HeyImK/Vector-06/Images/vectrbl.png

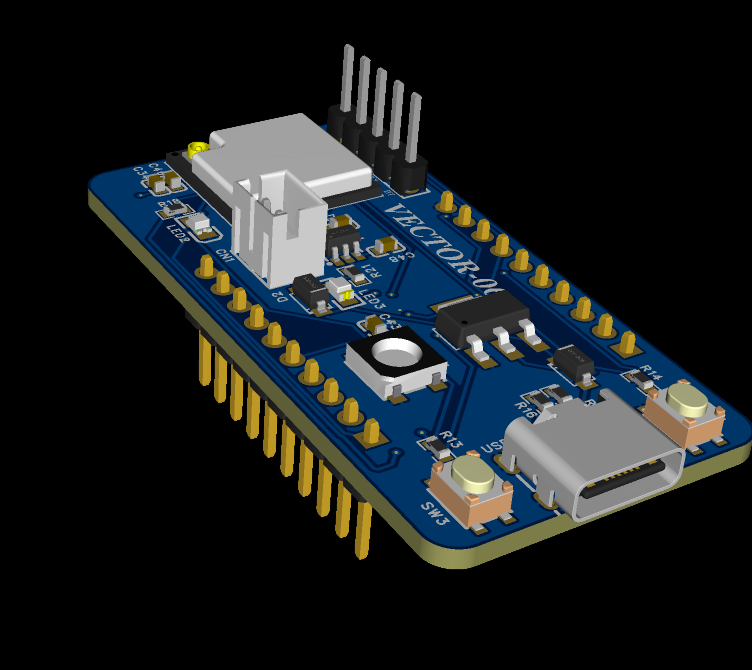
Images/vectrbl.png
