HeyImK/Vector-06/Images/vectrgren.png

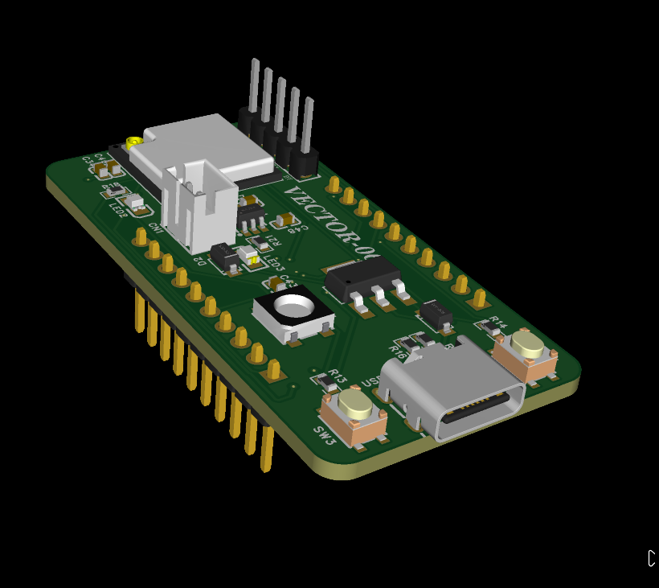
Images/vectrgren.png
