HeyImK/Vector-06/Images/vectrrred.png

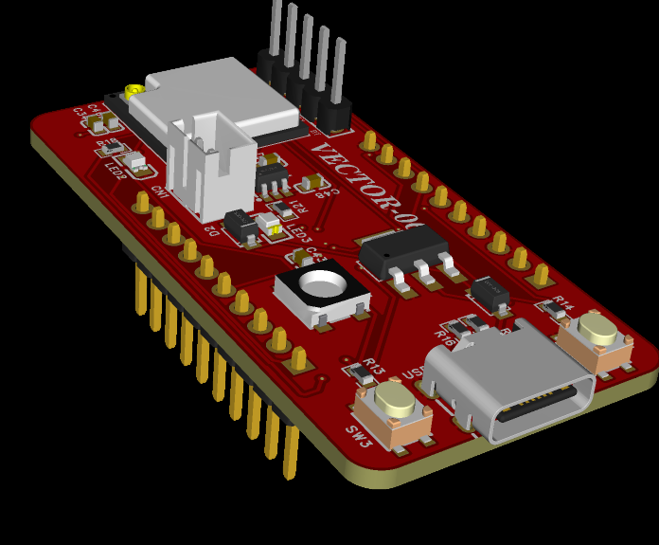
Images/vectrrred.png
