HeyImK/Vector-06/vector-06.pdf

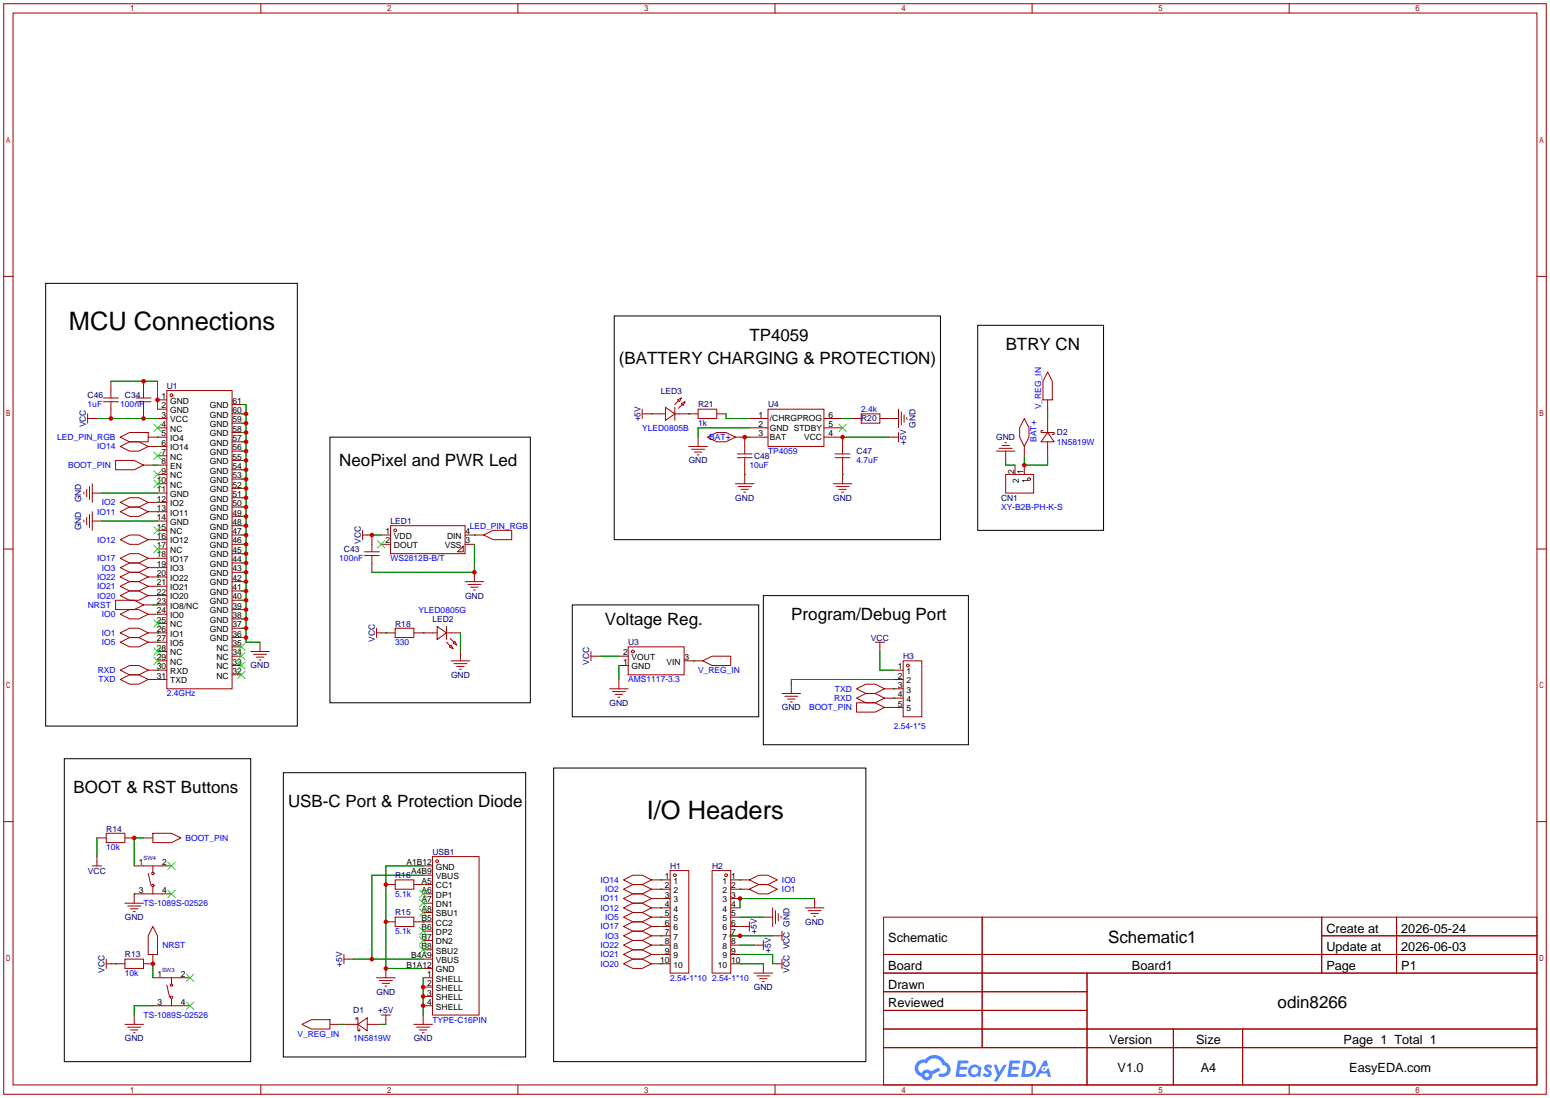
[picture p9: page 1]

NeoPixel and PWR Led

I/O Headers USB-C Port & Protection Diode

Schematic | Schematic1 | Create at | 2026-05-24

Update at | 2026-06-03

Board | Board1 | Page | P1
Drawn | | odin8266
Reviewed

Version | Size | Page 1 Total 1
V1.0 | A4 | EasyEDA.com
