HeyImK/Vector-06/(list of files, drawings)

Other design files:
SRC/smol32src.epro
SRC/vector-06-easyeda.epro
