HeyImK/Vector-06/(commit log)

2026-06-05 Revise README for VECTOR-06 with detailed specifications
    Updated the README to provide detailed information about the VECTOR-06 development board, including features, hardware architecture, pinout configuration, and licensing.
2026-06-26 Update README.md for clarity and conciseness
    Removed 'massive' from capacitor description and simplified logic-level shifter mention.
